HWS-XMS/CW308_XCSU/hw/CW308_KICAD.kicad_pcb

## KiCad design hw/CW308_KICAD.kicad_pcb (2026-09-25)

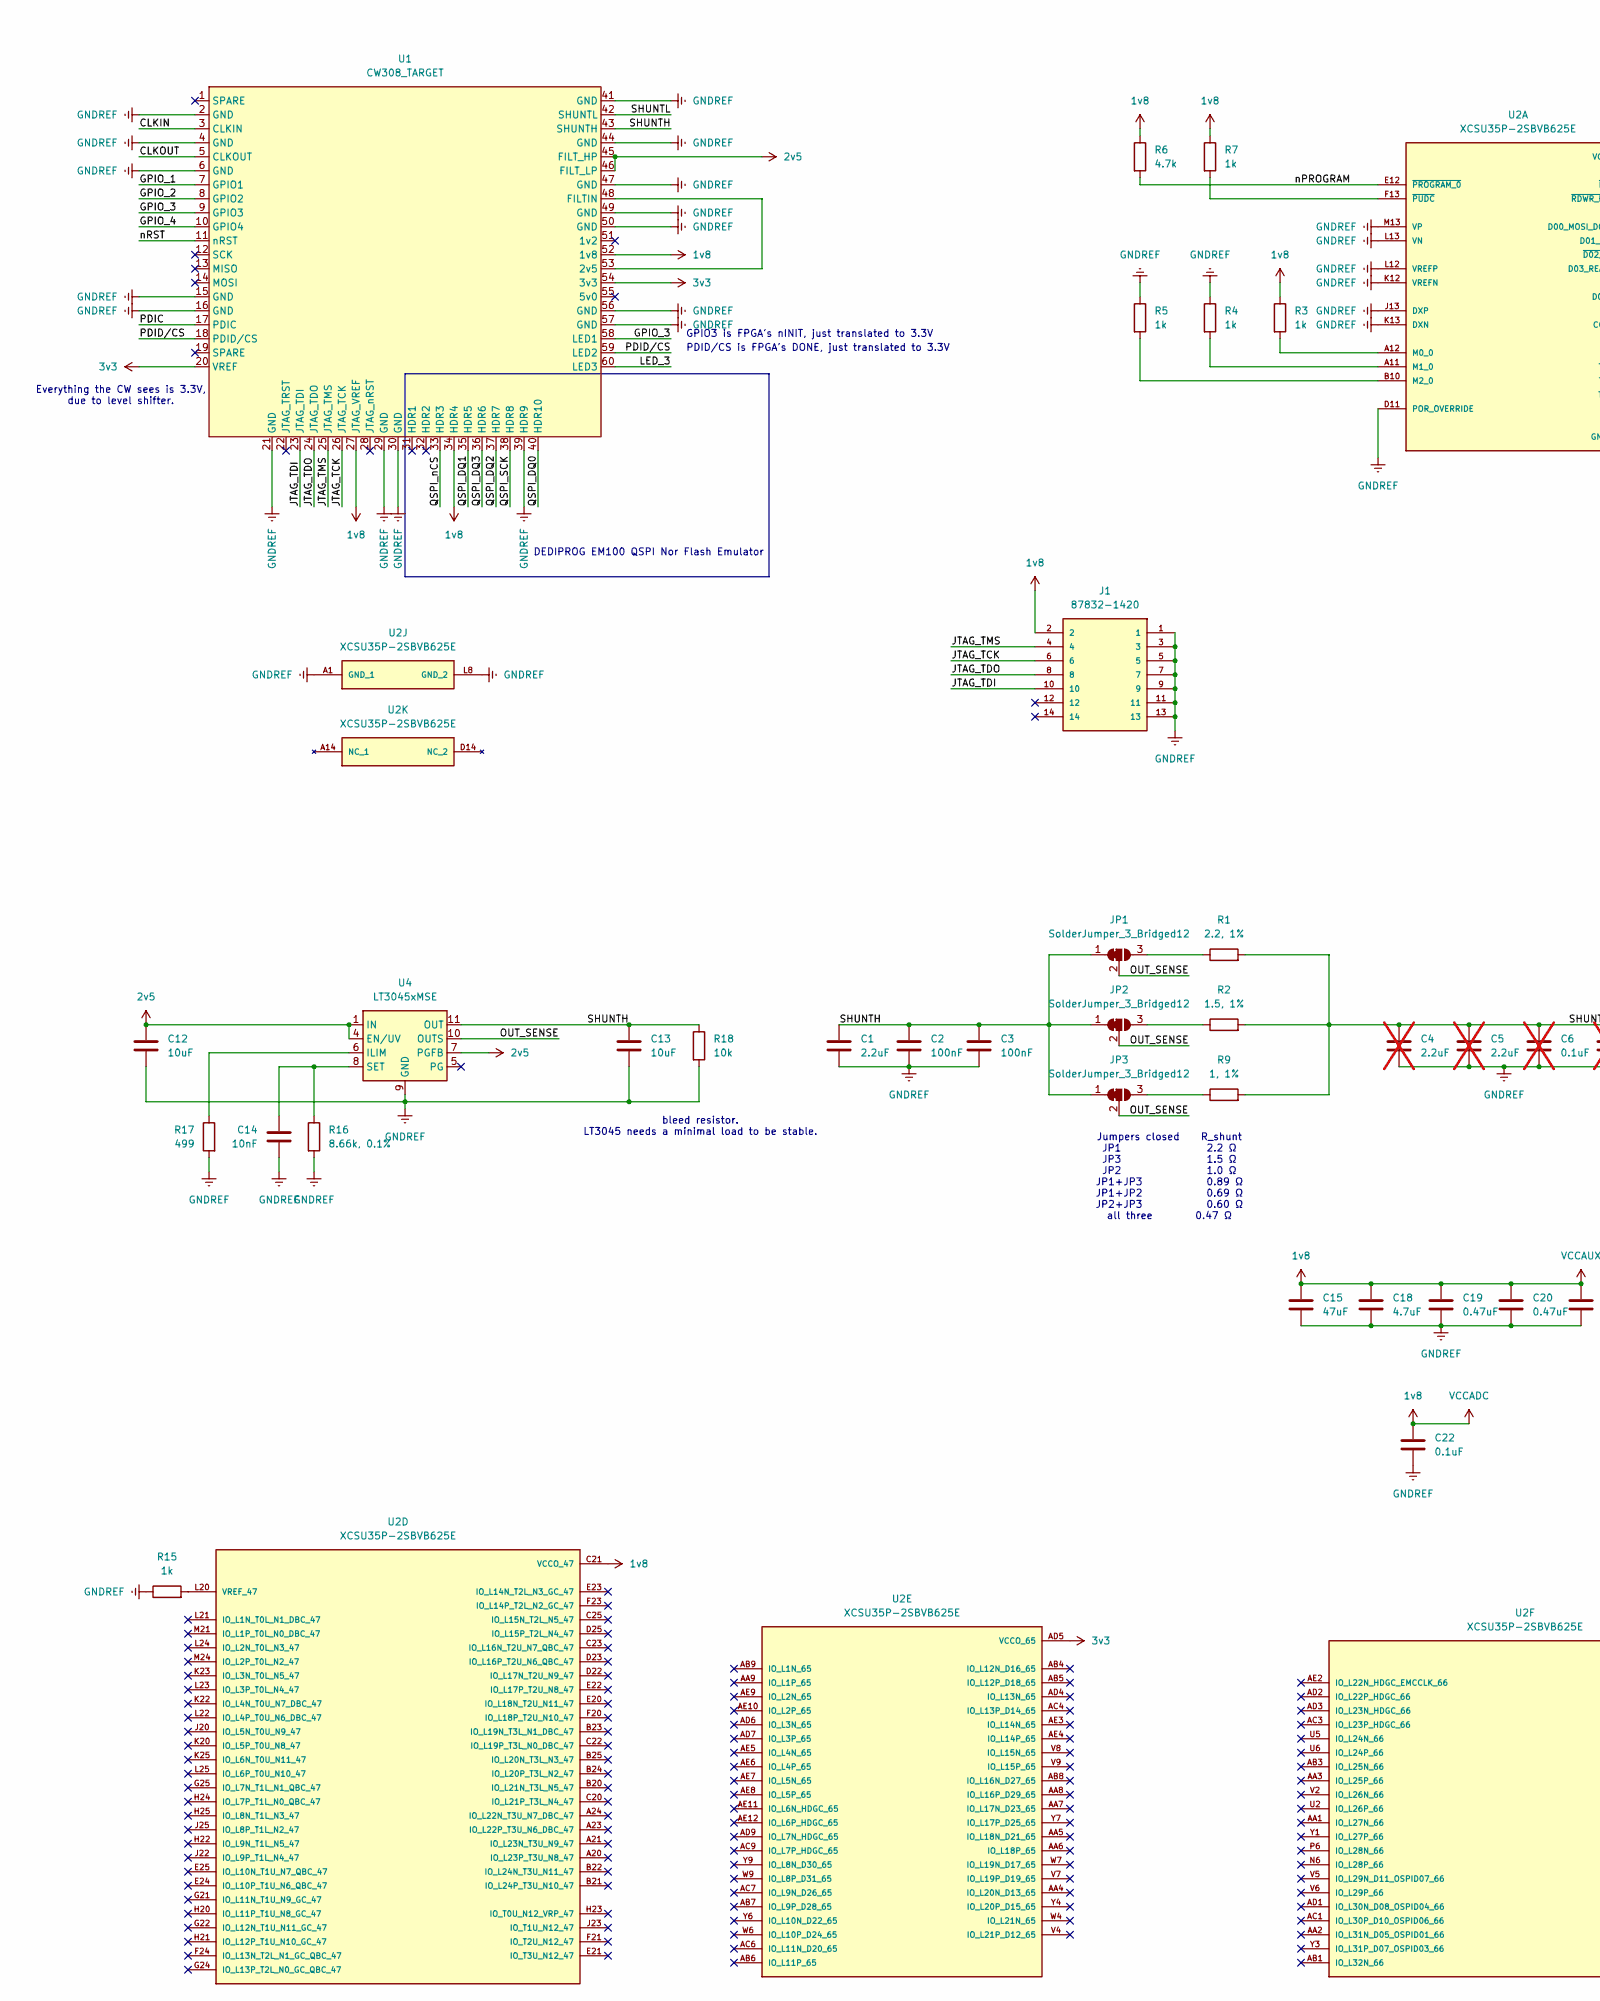
[picture p2: schematic CW308_KICAD.kicad_sch, part in row 1, column 1]

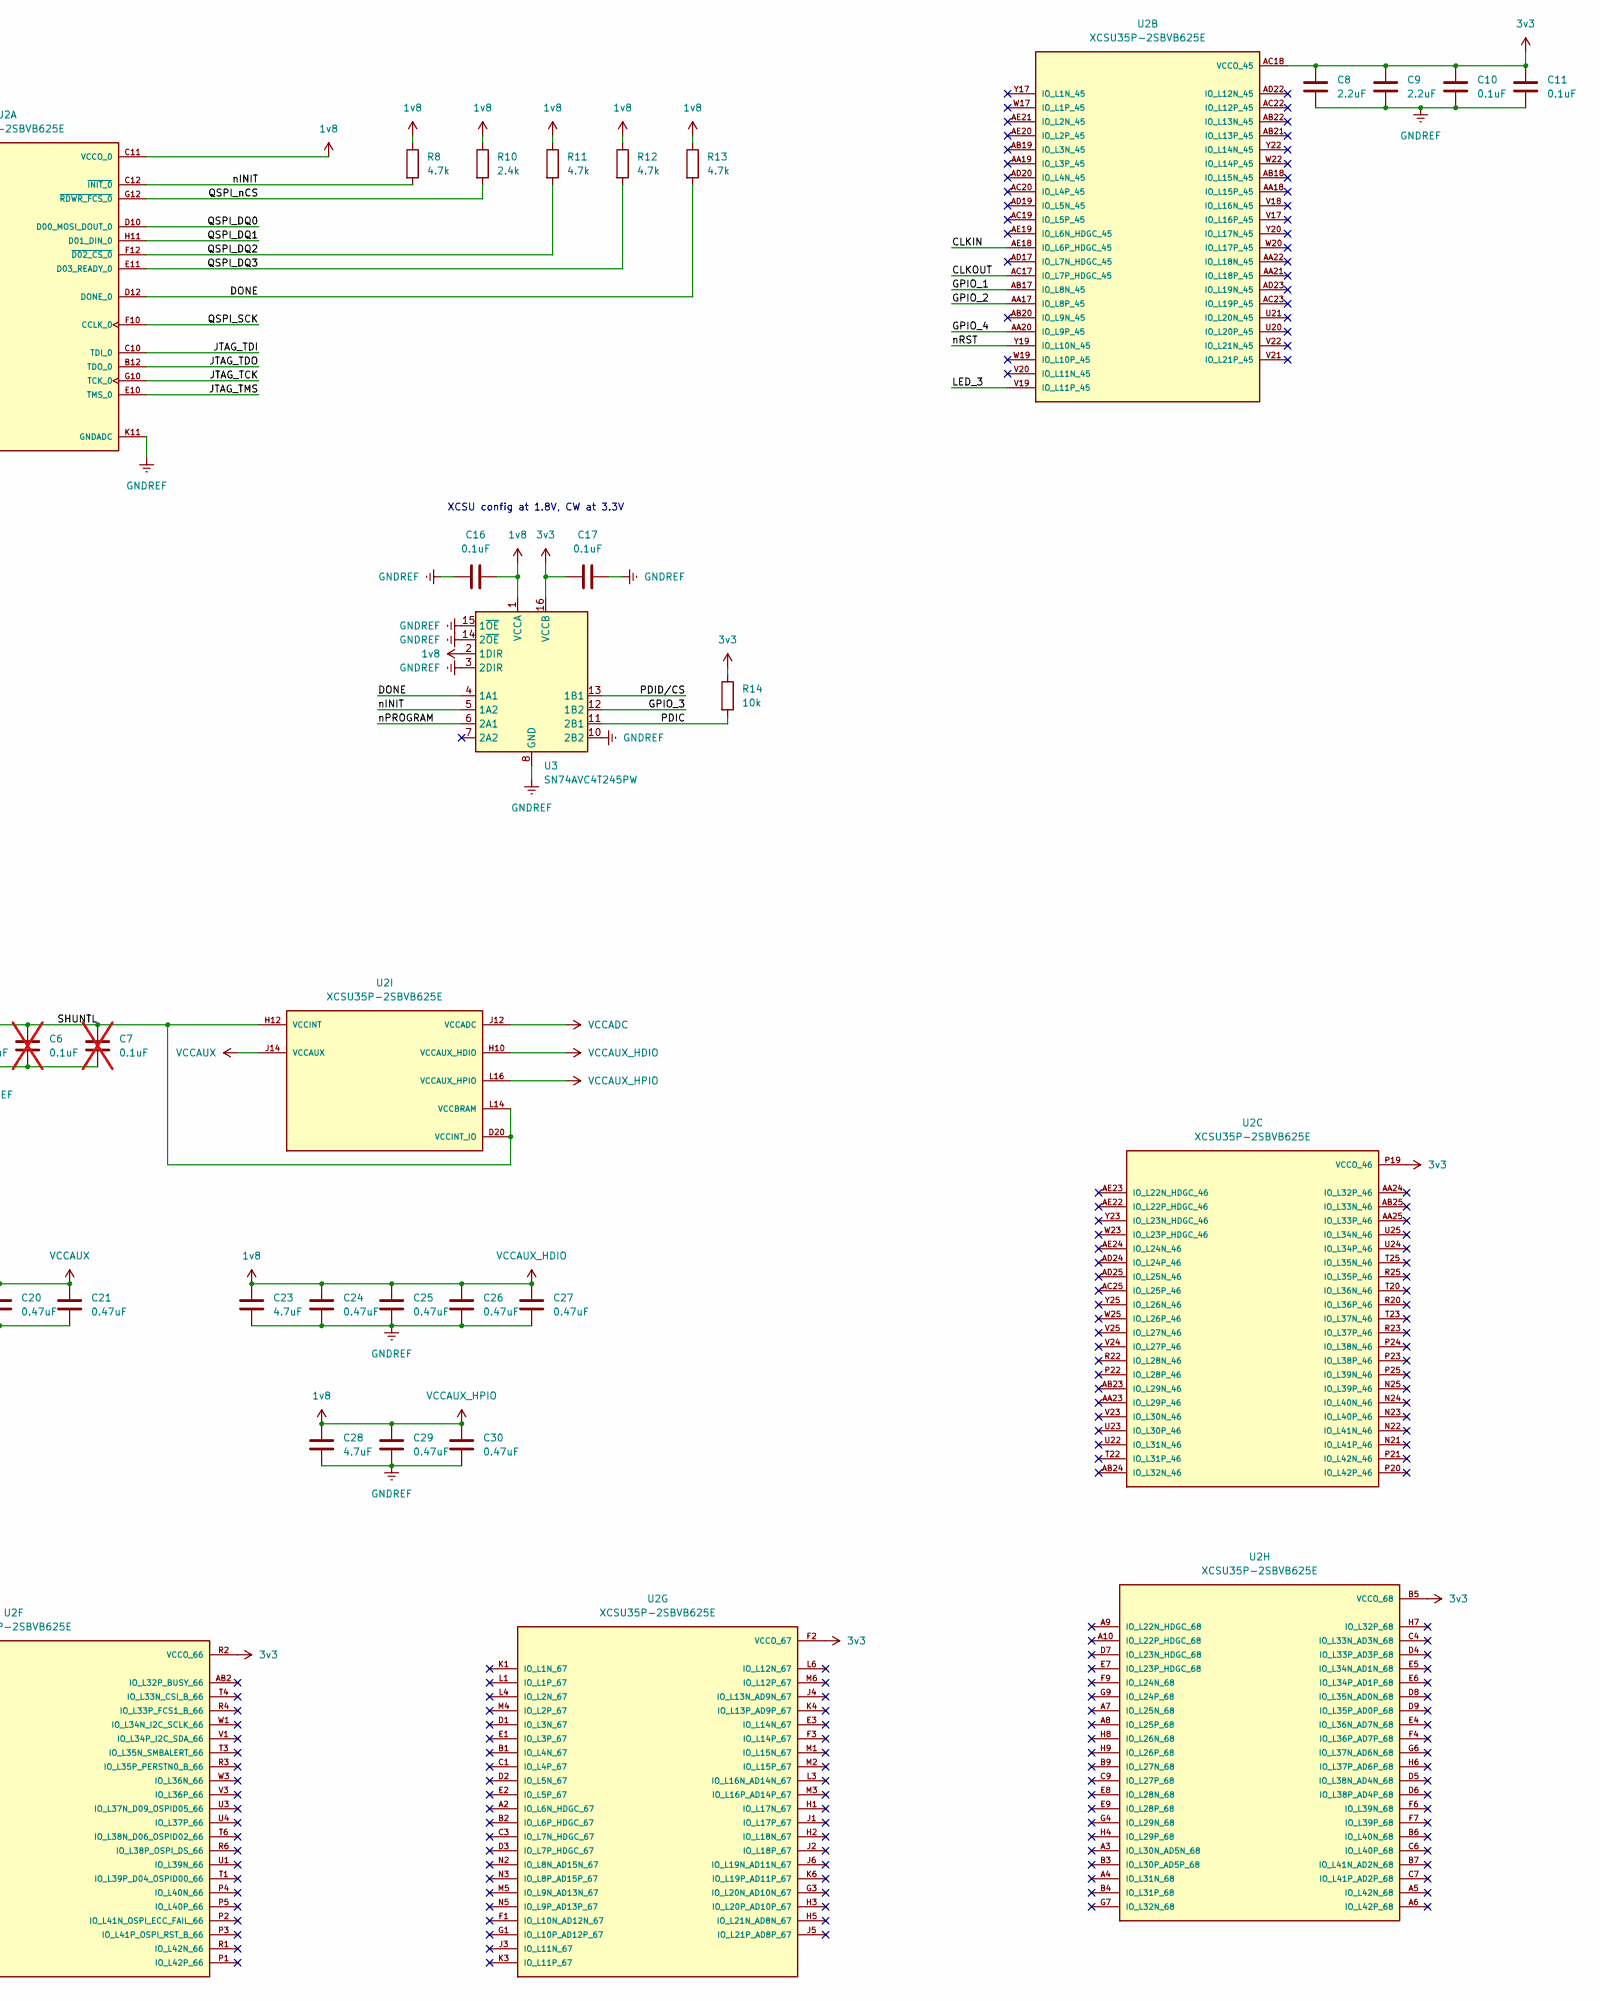
[picture p3: schematic CW308_KICAD.kicad_sch, part in row 1, column 2]

Parts:
C1, C8, C9: 2.2uF; C_0603_1608Metric
C2, C3: 100nF; C_0402_1005Metric
C4, C5: 2.2uF; C_0603_1608Metric; not fitted
C6, C7: 0.1uF; C_0402_1005Metric; not fitted
C10, C11, C16, C17, C22: 0.1uF; C_0402_1005Metric
C12, C13: 10uF; C_0805_2012Metric
C14: 10nF; C_0402_1005Metric
C15: 47uF; C_1206_3216Metric
C18, C23, C28: 4.7uF; C_0603_1608Metric
C19, C20, C21, C24, C25, C26, C27, C29, C30: 0.47uF; C_0402_1005Metric
J1: 87832-1420; MOLEX_87832-1420
JP1, JP2, JP3: SolderJumper_3_Bridged12; SolderJumper-3_P1.3mm_Bridged12_RoundedPad1.0x1.5mm
R1: 2.2, 1%; R_2512_6332Metric
R2: 1.5, 1%; R_2512_6332Metric
R3, R4, R5, R7, R15: 1k; R_0402_1005Metric
R6, R8, R11, R12, R13: 4.7k; R_0402_1005Metric
R9: 1, 1%; R_2512_6332Metric
R10: 2.4k; R_0402_1005Metric
R14: 10k; R_0402_1005Metric
R16: 8.66k, 0.1%; R_0402_1005Metric
R17: 499; R_0402_1005Metric
R18: 10k; R_0805_2012Metric
U1: CW308_TARGET
U2: XCSU35P-2SBVB625E; BGA625C80P25X25_2100X2100X192; PARTREV v4.10
U3: SN74AVC4T245PW; TSSOP-16_4.4x5mm_P0.65mm
U4: LT3045xMSE; MSOP-12-1EP_3x4.039mm_P0.65mm_EP1.651x2.845mm

Connections:
1v8: C15.1, C16.2, C18.1, C19.1, C20.1, C21.1, C22.1, C23.1, C24.1, C25.1, C26.1, C27.1, C28.1, C29.1, C30.1, J1.2, R3.1, R6.1, R7.1, R8.1, R10.1, R11.1, R12.1, R13.1, U1.27 (JTAG_VREF), U1.34 (HDR4), U1.52 (1v8), U2.C11 (VCCO_0), U2.C21 (VCCO_47), U2.D24 (VCCO_47), U2.G11 (VCCO_0), U2.H10 (VCCAUX_HDIO), U2.J10 (VCCAUX_HDIO), U2.J12 (VCCADC), U2.J14 (VCCAUX), U2.J17 (VCCAUX_HDIO), U2.J18 (VCCAUX_HDIO), U2.K8 (VCCAUX_HDIO), U2.K9 (VCCAUX_HDIO), U2.K21 (VCCO_47), U2.K24 (VCCO_47), U2.L16 (VCCAUX_HPIO), U2.L18 (VCCO_47), U2.M11 (VCCAUX), U2.M19 (VCCAUX_HPIO), U2.M22 (VCCAUX_HPIO), U2.N7 (VCCAUX_HDIO), U2.N11 (VCCAUX), U2.N12 (VCCO_0), U2.N14 (VCCAUX), U2.N16 (VCCAUX_HDIO), U2.N18 (VCCAUX_HDIO), U2.N20 (VCCAUX_HPIO), U2.P15 (VCCAUX), U2.R11 (VCCAUX), U2.R14 (VCCAUX), U2.R18 (VCCAUX_HDIO), U2.T8 (VCCAUX_HDIO), U2.T9 (VCCAUX_HDIO), U2.T15 (VCCAUX), U2.T18 (VCCAUX_HDIO), U2.U10 (VCCAUX_HDIO), U2.U16 (VCCAUX_HDIO), U2.U17 (VCCAUX_HDIO), U3.1 (VCCA), U3.2 (1DIR)
2v5: C12.1, U1.45 (FILT_HP), U1.46 (FILT_LP), U4.1 (IN), U4.2 (IN), U4.3 (IN), U4.4 (EN/UV), U4.7 (PGFB)
3v3: C8.2, C9.2, C10.2, C11.2, C17.1, R14.1, U1.20 (VREF), U1.54 (3v3), U2.AC18 (VCCO_45), U2.AC21 (VCCO_45), U2.AD5 (VCCO_65), U2.AD8 (VCCO_65), U2.B5 (VCCO_68), U2.C8 (VCCO_68), U2.F2 (VCCO_67), U2.F5 (VCCO_68), U2.G8 (VCCO_68), U2.J8 (VCCO_68), U2.K7 (VCCO_67), U2.L2 (VCCO_67), U2.L5 (VCCO_67), U2.L7 (VCCO_67), U2.P19 (VCCO_46), U2.R2 (VCCO_66), U2.R5 (VCCO_66), U2.R7 (VCCO_66), U2.R19 (VCCO_46), U2.R21 (VCCO_46), U2.T7 (VCCO_66), U2.T24 (VCCO_46), U2.U8 (VCCO_65), U2.U19 (VCCO_45), U2.W2 (VCCO_66), U2.W8 (VCCO_65), U2.W18 (VCCO_45), U2.W21 (VCCO_45), U2.Y5 (VCCO_65), U2.Y24 (VCCO_46), U3.16 (VCCB)
/CLKIN: U1.3 (CLKIN), U2.AE18 (IO_L6P_HDGC_45)
/CLKOUT: U1.5 (CLKOUT), U2.AC17 (IO_L7P_HDGC_45)
/DONE: R13.2, U2.D12 (DONE_0), U3.4 (1A1)
/GPIO_1: U1.7 (GPIO1), U2.AB17 (IO_L8N_45)
/GPIO_2: U1.8 (GPIO2), U2.AA17 (IO_L8P_45)
/GPIO_3: U1.9 (GPIO3), U1.58 (LED1), U3.12 (1B2)
/GPIO_4: U1.10 (GPIO4), U2.AA20 (IO_L9P_45)
/JTAG_TCK: J1.6, U1.26 (JTAG_TCK), U2.G10 (TCK_0)
/JTAG_TDI: J1.10, U1.23 (JTAG_TDI), U2.C10 (TDI_0)
/JTAG_TDO: J1.8, U1.24 (JTAG_TDO), U2.B12 (TDO_0)
/JTAG_TMS: J1.4, U1.25 (JTAG_TMS), U2.E10 (TMS_0)
/LED_3: U1.60 (LED3), U2.V19 (IO_L11P_45)
/OUT_SENSE: JP1.2 (C), JP2.2 (C), JP3.2 (C), U4.10 (OUTS)
/PDIC: R14.2, U1.17 (PDIC), U3.11 (2B1)
/PDID/CS: U1.18 (PDID/CS), U1.59 (LED2), U3.13 (1B1)
/QSPI_DQ0: U1.40 (HDR10), U2.D10 (D00_MOSI_DOUT_0)
/QSPI_DQ1: U1.35 (HDR5), U2.H11 (D01_DIN_0)
/QSPI_DQ2: R11.2, U1.37 (HDR7), U2.F12 (~D02_CS_0)
/QSPI_DQ3: R12.2, U1.36 (HDR6), U2.E11 (D03_READY_0)
/QSPI_SCK: U1.38 (HDR8), U2.F10 (CCLK_0)
/QSPI_nCS: R10.2, U1.33 (HDR3), U2.G12 (~RDWR_FCS_0)
/SHUNTH: C1.1, C2.1, C3.1, C13.1, JP1.1 (A), JP2.1 (A), JP3.1 (A), R18.1, U1.43 (SHUNTH), U4.11 (OUT), U4.12 (OUT)
/nINIT: R8.2, U2.C12 (~INIT_0), U3.5 (1A2)
/nPROGRAM: R6.2, U2.E12 (~PROGRAM_0), U3.6 (2A1)
/nRST: U1.11 (nRST), U2.Y19 (IO_L10N_45)
GNDREF: C1.2, C2.2, C3.2, C4.2, C5.2, C6.2, C7.2, C8.1, C9.1, C10.1, C11.1, C12.2, C13.2, C14.2, C15.2, C16.1, C17.2, C18.2, C19.2, C20.2, C21.2, C22.2, C23.2, C24.2, C25.2, C26.2, C27.2, C28.2, C29.2, C30.2, J1.1, J1.3, J1.5, J1.7, J1.9, J1.11, J1.13, R4.1, R5.1, R15.1, R16.2, R17.2, R18.2, U1.2 (GND), U1.4 (GND), U1.6 (GND), U1.15 (GND), U1.16 (GND), U1.21 (GND), U1.29 (GND), U1.30 (GND), U1.39 (HDR9), U1.41 (GND), U1.44 (GND), U1.47 (GND), U1.49 (GND), U1.50 (GND), U1.56 (GND), U1.57 (GND), U2.A1 (GND_1), U2.A13 (GND_1), U2.A22 (GND_1), U2.A25 (GND_1), U2.AB13 (GND_1), U2.AC2 (GND_1), U2.AC5 (GND_1), U2.AC8 (GND_1), U2.AC24 (GND_1), U2.AD11 (GND_1), U2.AD15 (GND_1), U2.AD18 (GND_1), U2.AD21 (GND_1), U2.AE1 (GND_1), U2.AE13 (GND_1), U2.AE25 (GND_1), U2.B8 (GND_1), U2.B11 (GND_1), U2.B15 (GND_1), U2.B18 (GND_1), U2.C2 (GND_1), U2.C5 (GND_1), U2.C24 (GND_1), U2.D11 (POR_OVERRIDE), U2.D13 (GND_1), U2.D21 (GND_1), U2.F8 (GND_1), U2.F11 (GND_1), U2.F15 (GND_1), U2.F18 (GND_1), U2.F22 (GND_1), U2.F25 (GND_1), U2.G2 (GND_1), U2.G5 (GND_1), U2.G13 (GND_1), U2.G20 (GND_1), U2.G23 (GND_1), U2.J7 (GND_1), U2.J9 (GND_1), U2.J13 (DXP), U2.J16 (GND_1), U2.J19 (GND_1), U2.J21 (GND_1), U2.J24 (GND_1), U2.K2 (GND_1), U2.K5 (GND_1), U2.K10 (GND_1), U2.K11 (GNDADC), U2.K12 (VREFN), U2.K13 (DXN), U2.K15 (GND_1), U2.K18 (GND_1), U2.L8 (GND_2), U2.L11 (GND_1), U2.L12 (VREFP), U2.L13 (VN), U2.L15 (GND_1), U2.L17 (GND_1), U2.L19 (GND_2), U2.M7 (GND_2), U2.M9 (GND_2), U2.M13 (VP), U2.M14 (GND_2), U2.M16 (GND_2), U2.M20 (GND_2), U2.M23 (GND_2), U2.M25 (GND_2), U2.N1 (GND_2), U2.N4 (GND_2), U2.N8 (GND_2), U2.N10 (GND_2), U2.N13 (GND_2), U2.N15 (GND_2), U2.N17 (GND_2), U2.N19 (GND_2), U2.P7 (GND_2), U2.P9 (GND_2), U2.P11 (GND_2), U2.P12 (GND_2), U2.P14 (GND_2), U2.P16 (GND_2), U2.P18 (GND_2), U2.R8 (GND_2), U2.R10 (GND_2), U2.R13 (GND_2), U2.R15 (GND_2), U2.R17 (GND_2), U2.R24 (GND_2), U2.T2 (GND_2), U2.T5 (GND_2), U2.T11 (GND_2), U2.T14 (GND_2), U2.T16 (GND_2), U2.T19 (GND_2), U2.T21 (GND_2), U2.U7 (GND_2), U2.U9 (GND_2), U2.U12 (GND_2), U2.U18 (GND_2), U2.W5 (GND_2), U2.W13 (GND_2), U2.W24 (GND_2), U2.Y2 (GND_2), U2.Y8 (GND_2), U2.Y11 (GND_2), U2.Y15 (GND_2), U2.Y18 (GND_2), U2.Y21 (GND_2), U3.3 (2DIR), U3.8 (GND), U3.9 (GND), U3.10 (2B2), U3.14 (2~OE), U3.15 (1~OE), U4.9 (GND), U4.13 (GND)
unnamed: JP1.3 (B), R1.1
unnamed: JP2.3 (B), R2.1
unnamed: JP3.3 (B), R9.1
unnamed: U1.48 (FILTIN), U1.53 (2v5)
unnamed: R3.2, U2.A12 (M0_0)
unnamed: R4.2, U2.A11 (M1_0)
unnamed: R5.2, U2.B10 (M2_0)
unnamed: R7.2, U2.F13 (~PUDC)
unnamed: R15.2, U2.L20 (VREF_47)
unnamed: R17.1, U4.6 (ILIM)
unnamed: C14.1, R16.1, U4.8 (SET)
VCCBRAM: C4.1, C5.1, C6.1, C7.1, R1.2, R2.2, R9.2, U1.42 (SHUNTL), U2.D20 (VCCINT_IO), U2.H12 (VCCINT), U2.H13 (VCCINT), U2.J11 (VCCINT), U2.K14 (VCCINT), U2.K16 (VCCINT_IO), U2.K17 (VCCINT_IO), U2.K19 (VCCINT_IO), U2.L9 (VCCINT), U2.L10 (VCCINT), U2.L14 (VCCBRAM), U2.M8 (VCCINT), U2.M10 (VCCINT), U2.M12 (VCCINT), U2.M15 (VCCINT), U2.M17 (VCCINT), U2.M18 (VCCINT), U2.N9 (VCCINT), U2.P8 (VCCINT), U2.P10 (VCCINT), U2.P13 (VCCBRAM), U2.P17 (VCCINT), U2.R9 (VCCINT), U2.R12 (VCCBRAM), U2.R16 (VCCINT), U2.T10 (VCCINT), U2.T12 (VCCINT), U2.T13 (VCCBRAM), U2.T17 (VCCINT), U2.U11 (VCCINT), U2.U13 (VCCBRAM), U2.U14 (VCCINT), U2.U15 (VCCINT), U2.V13 (VCCINT)

Notes on the sheet:
XCSU config at 1.8V, CW at 3.3V
DEDIPROG EM100 QSPI Nor Flash Emulator
Jumpers closed R_shunt JP1 2.2 Ω JP3 1.5 Ω JP2 1.0 Ω JP1+JP3 0.89 Ω JP1+JP2 0.69 Ω JP2+JP3 0.60 Ω all three 0.47 Ω
Everything the CW sees is 3.3V, due to level shifter.
GPIO3 is FPGA's nINIT, just translated to 3.3V
bleed resistor. LT3045 needs a minimal load to be stable.
PDID/CS is FPGA's DONE, just translated to 3.3V

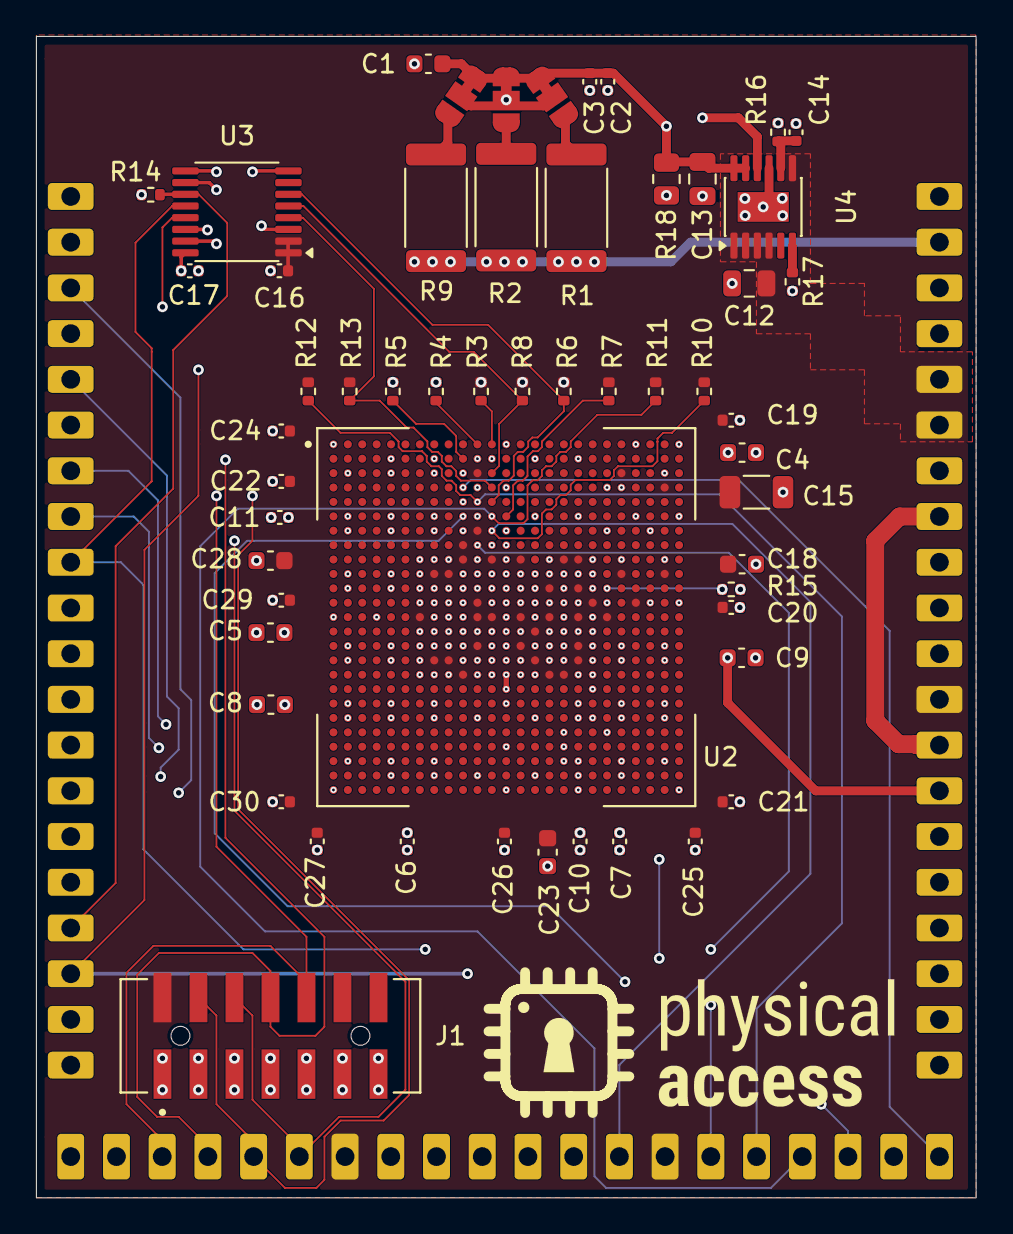
[picture p4: board CW308_KICAD.kicad_pcb from above]

Board: 4 copper layers, 52.2 x 64.5 mm, 56 parts (0 on the bottom side), 41 nets.
