HWS-XMS/CW308_XCSU/(commit log)

2026-09-25 Initial CW308 XCSU design
    4-layer CW308 UFO target board for the AMD XCSU35P-2SBVB625E
    (BGA625). Includes schematic, PCB, design rules, symbol and
    footprint libraries, the BGA 3D model, and the fabrication
    package sent to the board house.
    Deduplicate fp-lib-table: CW308_LIB was registered twice and a
    "Library" entry pointed at a non-existent Library.pretty directory.
    [CW308_KICAD.kicad_pcb, CW308_KICAD.kicad_sch, bom.csv, designators.csv, positions.csv]
2026-09-25 Remove redundant 87832-1420 symbol library
    The Molex 87832-1420 symbol is already defined inside
    CW308_LIB.kicad_sym, and the schematic references it as
    CW308_LIB:87832-1420. The standalone library was an unused
    leftover from the original import.
    Also drop its now-dead sym-lib-table entry.
2026-09-25 Attach XCSU 3D model to BGA625 footprint via KIPRJMOD
    The XCSU35P-2SBVB625E.step file shipped in CW308_LIB.pretty was not
    referenced by any footprint. Add a model block using ${KIPRJMOD} so
    the path resolves relative to the project directory and works on any
    clone, matching how the library tables already reference paths.
    Offset/scale/rotate are defaults and may need adjusting against the
    3D viewer.
2026-09-25 Add board render to README
2026-09-30 Testing the board, AES example circuit design, fully tested on Husky.
    [CW308_KICAD.kicad_pcb, CW308_KICAD.kicad_sch, bom.csv, designators.csv, positions.csv]
